ketaro-m/FootSens/README.md

FootSens
====
**A force tracking system to measure ground reaction forces in the foot.**

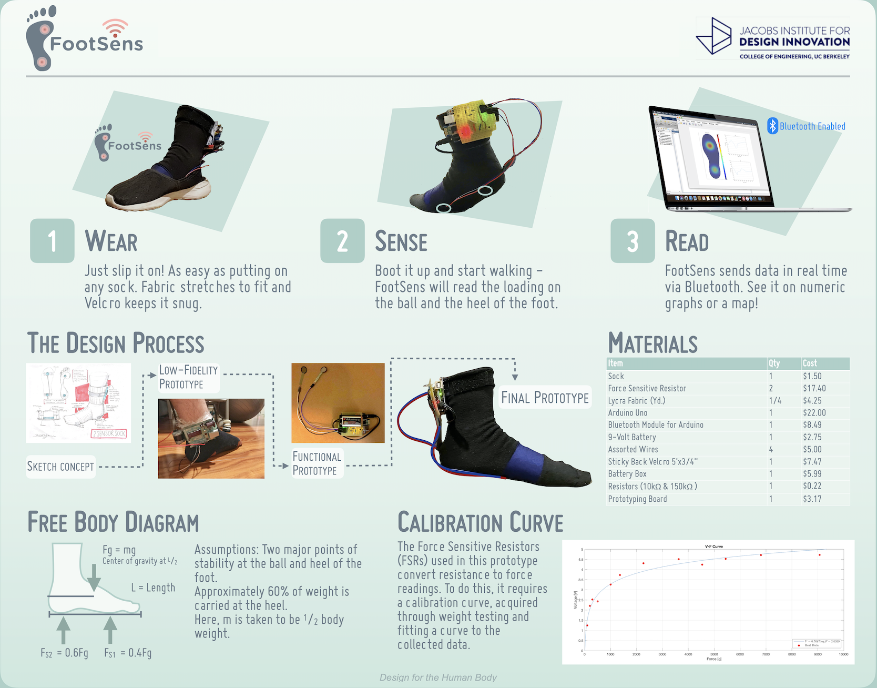
[picture p1: img/poster.png]
 


## Material

- [Arduino UNO R3](https://www.amazon.com/Arduino-Uno-R3-Microcontroller-A000066/dp/B008GRTSV6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)
- [Bluetooth Module HC-05](https://www.amazon.com/gp/product/B01G9KSAF6/ref=ppx_yo_dt_b_asin_title_o01_s00?ie=UTF8&psc=1) <- Only "HC-05" and "HC-06" are supported by MATLAB.
- [Force Sensing Resistor](https://www.amazon.com/gp/product/B00B887CLS/ref=ppx_yo_dt_b_asin_title_o03_s00?ie=UTF8&psc=1)
- Resistors; 10kΩ for FSRs and 10Ω for LED
- LED
- MATLAB R2019a ([Instrument Control Toolbox](https://jp.mathworks.com/products/instrument.html) installed)

## Circuit
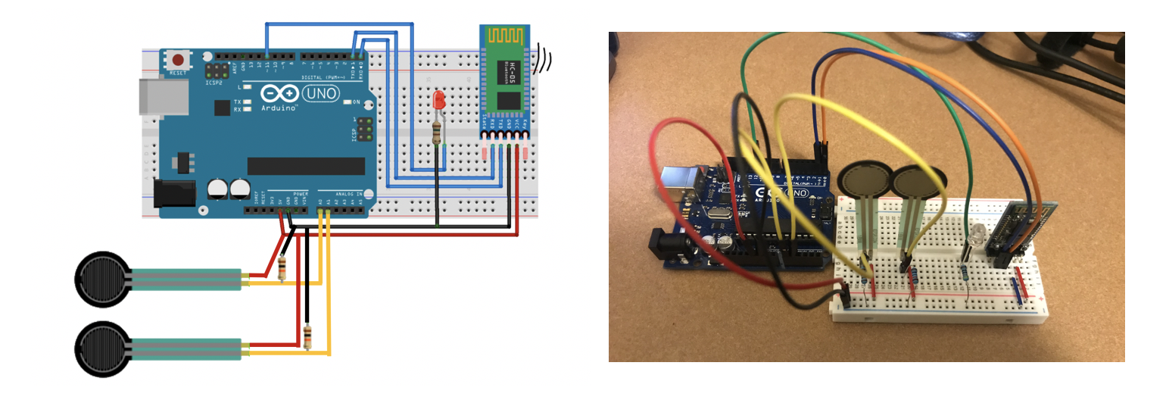
[picture p2: img/circuit.png]


## Prototype
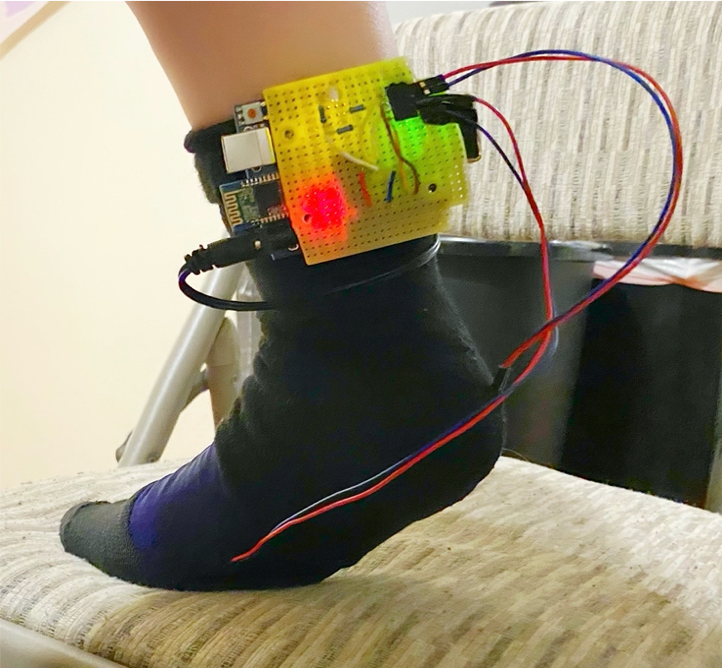
[picture p3: img/prototype2.png]
 

## Usage
### Initial Setting
At first, you need to connect the device to your computer itself. PIN number for this bluetooth module is "1234".
- Mac  
"System Preferences" -> "Bluetooth" -> "Devices"
- Windows  
"Settings" -> "Devices" -> "Bluetooth & other devices"

### Command on MATLAB
Once you open MATLAB, please connect the device typing these command.
```
>> instrhwinfo('Bluetooth','DSD TECH HC-05');
>> bt = Bluetooth('DSD TECH HC-05', 1);
>> fopen(bt);
```
If you successfully open the bluetooth, move to the directory in which "main.m" exists and run it.
```
>> main
```
Then input a file name and measurement time into a dialog showing up, and click "OK".
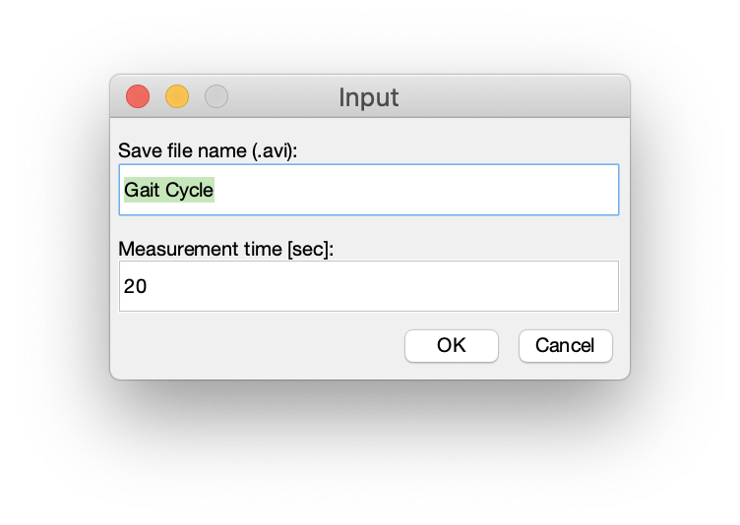
[picture p4: img/inputDialog.png]


In a few seconds, LED on the device will turn on and the measurement will start.  
You can monitor the tracknig in real time and the screen will be saved as an avi file in the same directory.

## Demo
