ketaro-m/FootSens/ProjectReport/Final Project Brainstorming.pdf

Group 12: Keitaro, Kristin, Radhika, Revati, Tiana

Final Project Brainstorming: Foot Load Sensing

Brainstormed Ideas:

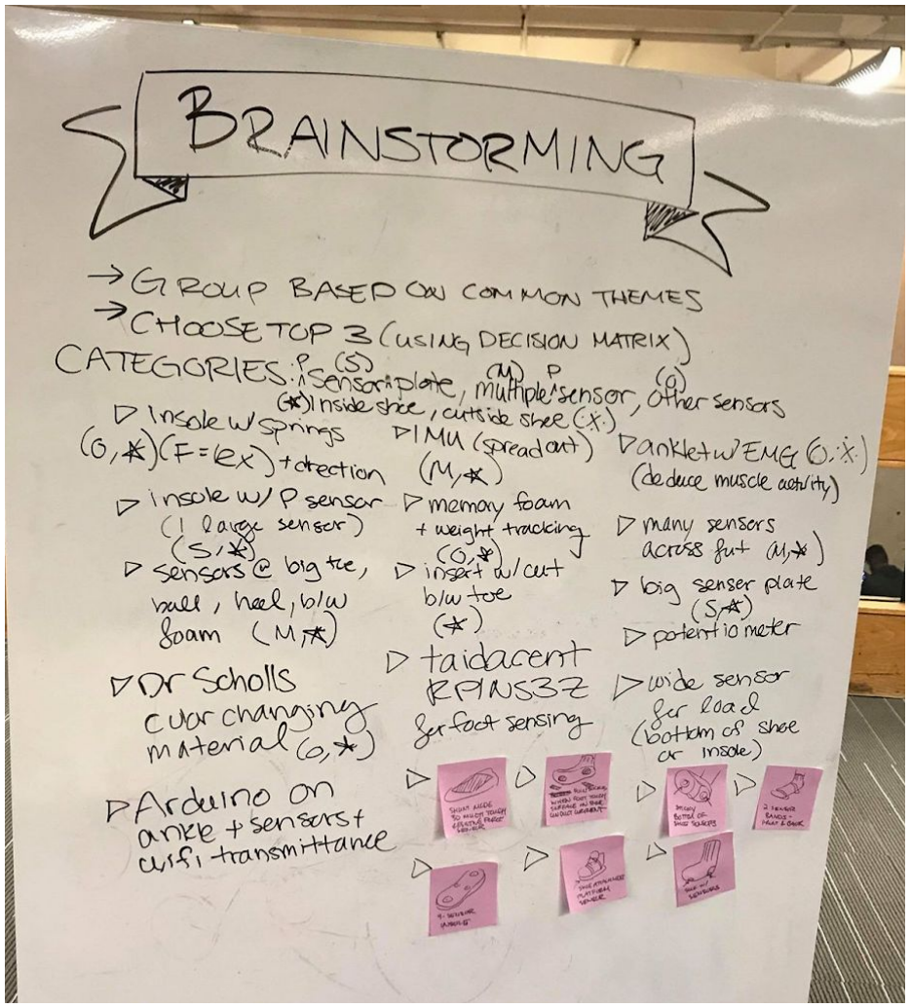
[picture p13: figure]

Total: 21 Ideas

Common themes: Sensor plate, multiple individual sensors, other types of sensors (not directly force/weight/pressure sensors), inside shoe, and outside shoe.

This resulted in the following classifications:

Sensor plate, inside shoe: Insole with pressure sensor (large), big sensor plate (alone), taidescent RPINS3Z (large sensor), shunt mode 3D touch sensor

Multiple sensors, inside shoe: Spread-out IMU, many sensors across foot, sensors (at toe, ball, heel) between foam sheets, insert with cut between toe, two sensor bands around foot, 4 sensor insole, sock with sensors

Other sensors, inside shoe: Insole with springs, memory foam weight tracking, potentiometer, Dr. Scholl’s color changing material, electrical conductivity socks + conductive strip on shoes

Sensor plate, outside shoe: Wide load sensor at bottom of shoe, shoe attachment platform sensor (strapped)

Multiple sensors, outside shoe: Arduino on ankle with sensors and wi-fi transmittance, sticky bottom of shoe sensors

Other sensors, outside shoe: Anklet bracelet with EMG to see how muscles firing lead to different motions

Decision Matrix

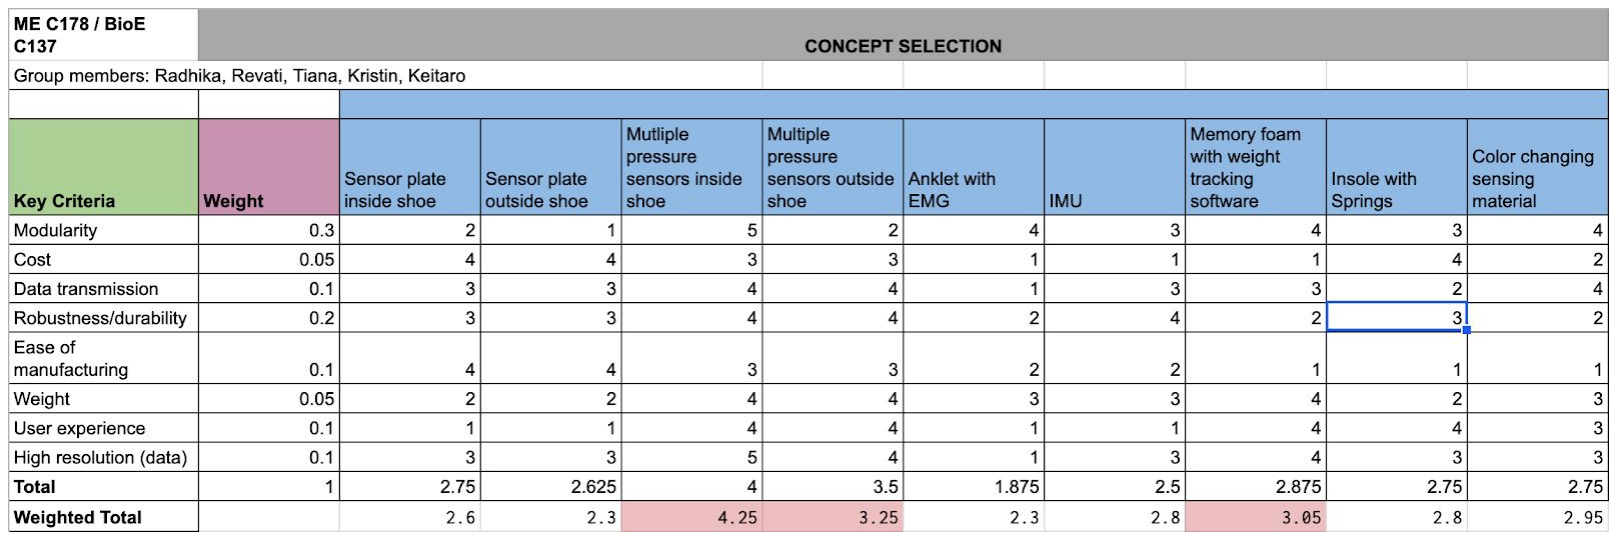
[picture p14: figure]

Sketches of Top 3 Ideas

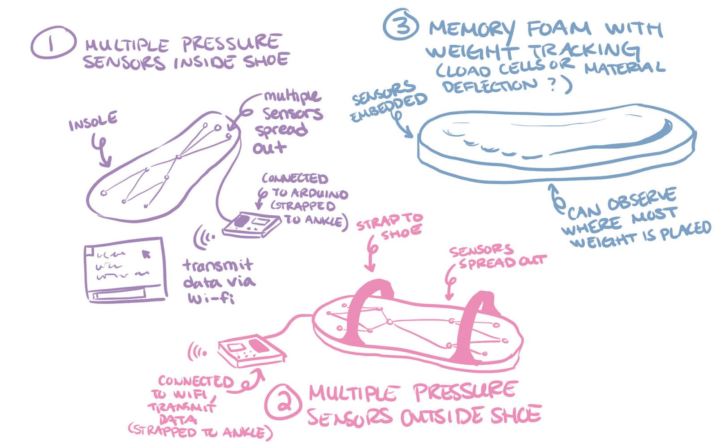
[picture p15: figure]

Feedback from Mentor

- Insole seems like the best bet — get the most accurate readings from pressure sensors that closely interface with the foot, rather than something that has a layer of material in between
- Focus on 2 pressure sensors for now — using several sensors might result in a lot of noise in the data/difficult to wire leads to all sensors
- Consider comfort (go with the sock rather than the insole), may even be more modular for the wearer
- Data readout is a good idea, but for low fidelity prototype, focus on the sensor itself

Sketch of Reformulated Top Idea

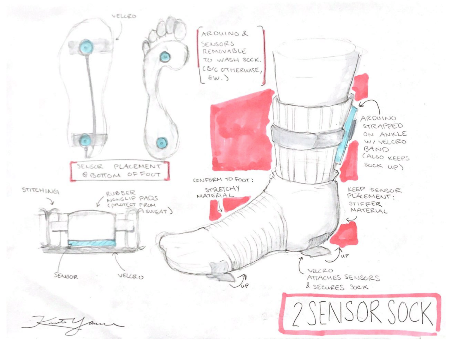
[picture p16: figure]

Bill of Materials (BOM) (Theoretical)

Item No. | Qt y | Item Name | Source | Cost | Comment s
0001 | 1 | Arduino | Class kit | $0 | Have
0002 | 2 | Small Force Sensors | Amazon or Adafruit | $7-30 ea. | Need to order
0003 | 1 | Sock | Target | $2.50 | Need to buy
0004 | 2+ | Extra wires for sensor (possibly more) | Amazon/Adafruit | $? | Need to order
0005 | 2 | Rubber pads | Amazon | $? | Need to order
0006 | 2 | Velcro Pads | Amazon | $6 | Need to order

References:
“Embedded Force Sensors.” Tekscan, 28 Oct. 2019, https://www.tekscan.com/products-solutions/embedded-force-sensors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.

How to Make Almost Anything, http://fab.cba.mit.edu/classes/863.12/people/calisch/14/foot.html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.

Hunsaker, Nathan. Novelusa.com: Systems/Software: Pedar, 1 Nov. 2019, https://www.novelusa.com/index.php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.

“Pedoped Insole for Load Analysis.” Lower Extremity Review Magazine, https://lermagazine.com/products/pedoped-insole-for-load-analysis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.

Reuß, Evelyn. “Pressure Sensor Shoe.” Costumes and Sensors, 1 July 2016, https://www.uni-weimar.de/projekte/costumes-and-sensors/pressure-sensor-shoe/.

“Smart Foot Sensor.” IEE,
https://www.iee.lu/en/products/sports-healthcare/smart-foot-sensor?fbclid=IwAR2Zhd2Fi9h7bw rgcOhmV0twiITDM2woyqV-Vb-FhF8jYOlU-MMOKPqKP7I.
