ketaro-m/FootSens/ForceSensorProperty/F-Vcurve.png

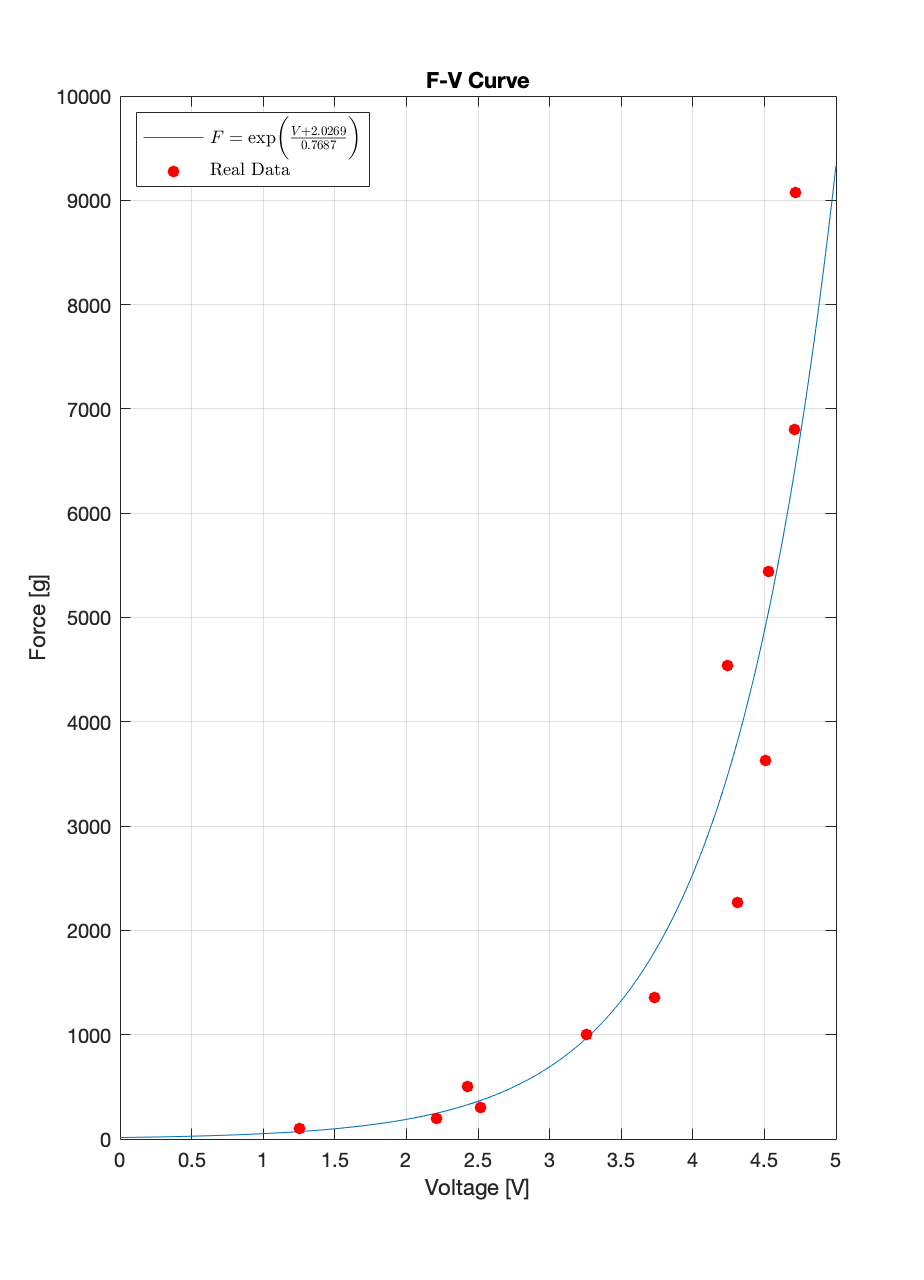
ForceSensorProperty/F-Vcurve.png
