ketaro-m/FootSens/ForceSensorProperty/RealData.png

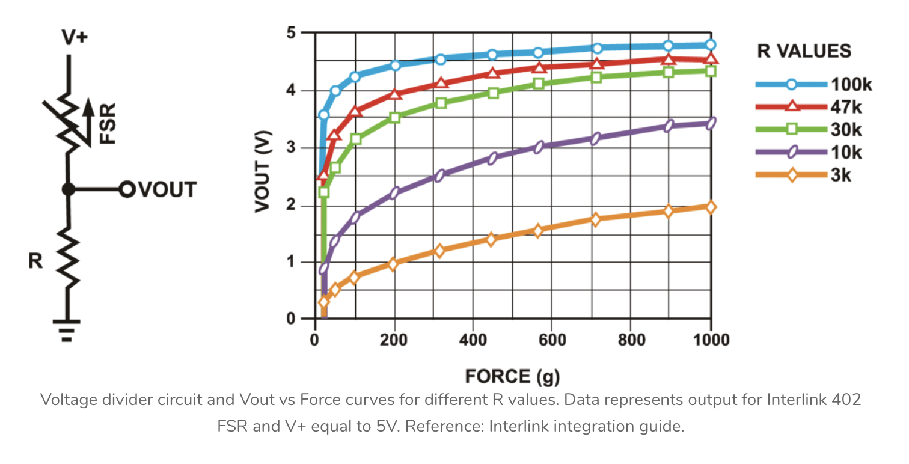
ForceSensorProperty/RealData.png
