ketaro-m/FootSens/ForceSensorProperty/V-Fcurve.png

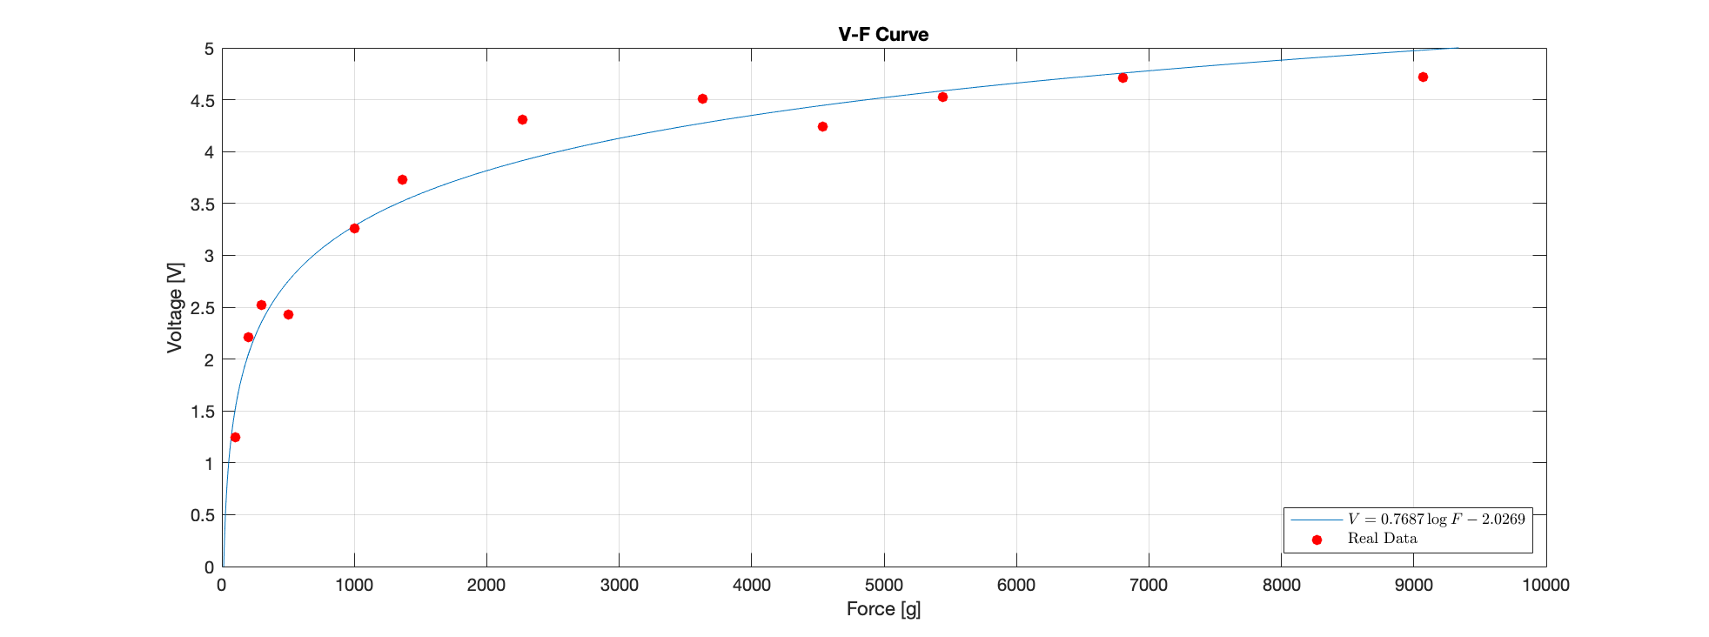
ForceSensorProperty/V-Fcurve.png
