ketaro-m/FootSens/img/demo.gif

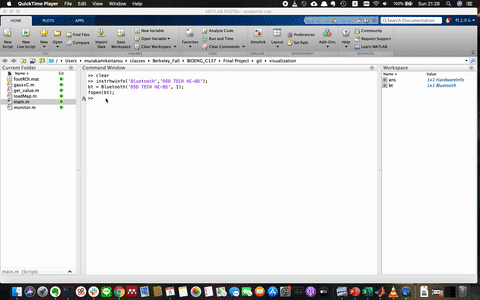
img/demo.gif
