ketaro-m/FootSens/ForceSensorProperty/Measurement.xlsx

Sheet: Actual Testing
Force[g] | Voltage
100 | 1.25
200 | 2.21
300 | 2.52
500 | 2.43
1000 | 3.26
1360.78 | 3.73
2267.96 | 4.31
3628.74 | 4.51
4535.92 | 4.24
5443.11 | 4.53
6803.89 | 4.71
9071.85 | 4.72

Sheet: Default
Force[g] | Voltage[V]
20 | 0.8
50 | 1.4
100 | 1.75
200 | 2.2
320 | 2.5
450 | 2.75
575 | 3
710 | 3.1
900 | 3.3
1000 | 3.4
