ketaro-m/FootSens/(commit log)

2019-11-01 add arduino
2019-11-16 send sensors values
2019-11-17 convert analog to voltage
2019-11-17 add sensor property
    [Measurement.xlsx]
2019-11-26 add timer
2019-12-08 change the sensor position and the caxis
2019-12-09 modified Sensor Property
    [Measurement.xlsx]
2019-12-13 Insert demo movie
